douwstrydom2/E-design-314-Project/Demo1.ioc

Mcu.UserName=STM32F411RETx
PA0-WKUP.Signal=S_TIM2_CH1_ETR
PA1.Signal=GPIO_Output
PA11.Signal=GPIO_Output
PA12.Signal=GPXTI12
PA13.Signal=SYS_JTMS-SWDIO
PA14.Signal=SYS_JTCK-SWCLK
PA15.Signal=GPXTI15
PA2.Signal=USART2_TX
PA3.Signal=USART2_RX
PA5.Signal=GPIO_Output
PA6.Signal=GPIO_Output
PA7.Signal=GPIO_Output
PB1.Signal=ADCx_IN9
PB13.Signal=GPXTI13
PB14.Signal=GPIO_Output
PB3.Signal=SPI1_SCK
PB4.Signal=SPI1_MISO
PB5.Signal=SPI1_MOSI
PB6.Signal=GPIO_Output
PB8.Signal=I2C1_SCL
PB9.Signal=I2C1_SDA
PC0.Signal=GPXTI0
PC1.Signal=GPXTI1
PC15-OSC32_OUT.Signal=GPIO_Output
PC2.Signal=GPXTI2
PC3.Signal=GPXTI3
PC4.Signal=GPXTI4
PC5.Signal=GPIO_Output
PC6.Signal=GPIO_Output
PC8.Signal=GPXTI8
